JesusFreke/lalboard_stls/thumb_cluster_left_assembly.stl

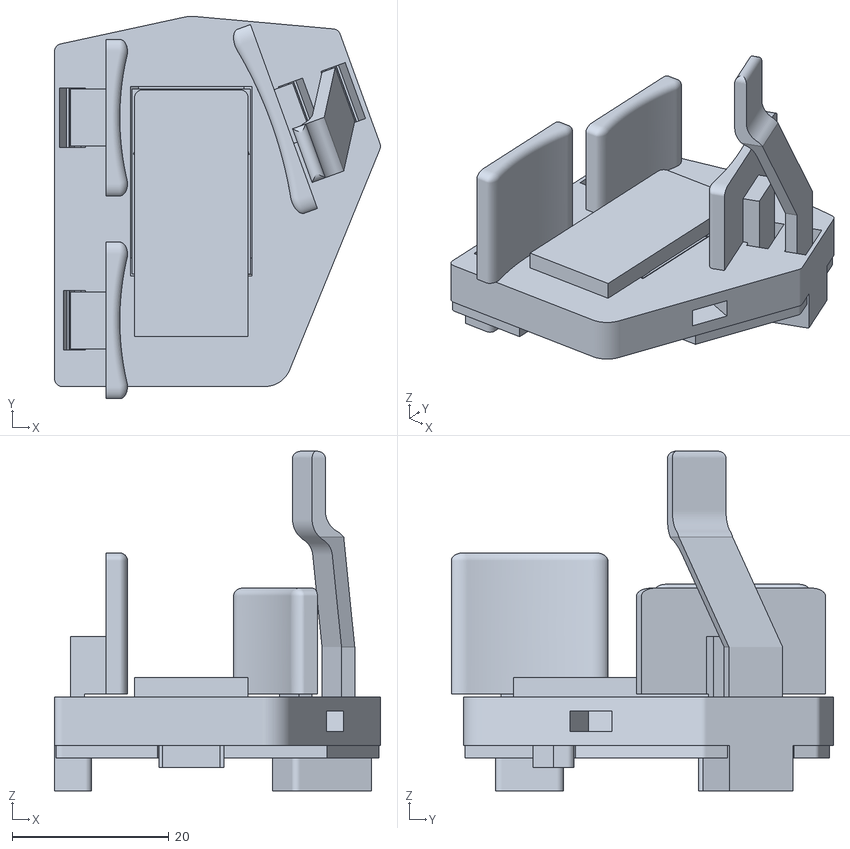
[picture p1: CAD file, 2021-03-22]
thumb_cluster_left_assembly.stl
41.6 x 48.8 x 43.4
