JesusFreke/lalboard_stls/central_pcb_spacer.3mf

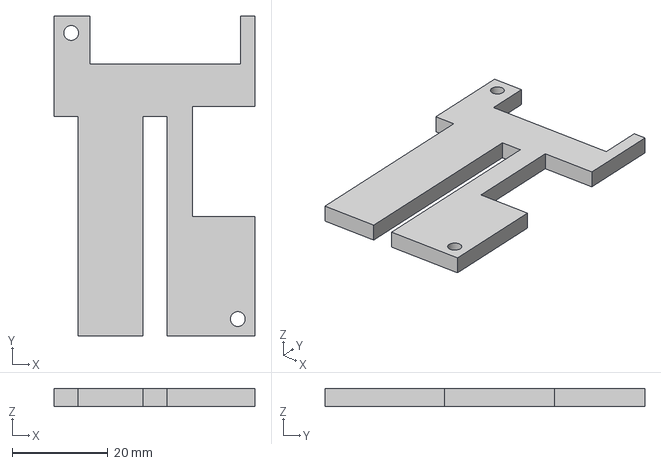
[picture p2: CAD file, 2024-06-17]
central_pcb_spacer.3mf
42.0 x 67.0 x 3.80 mm
