JesusFreke/lalboard_stls/cluster_pcb_sketch.dxf

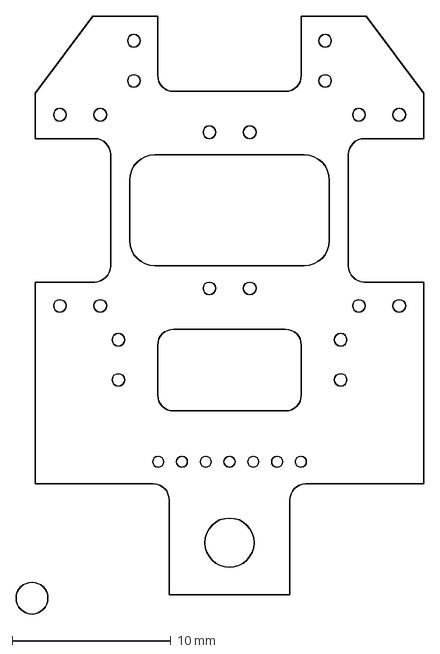
[picture p3: CAD file, 2023-11-19]
cluster_pcb_sketch.dxf
25.7 x 37.7 mm
