JesusFreke/lalboard_stls/thumb_cluster_insertion_tool.3mf

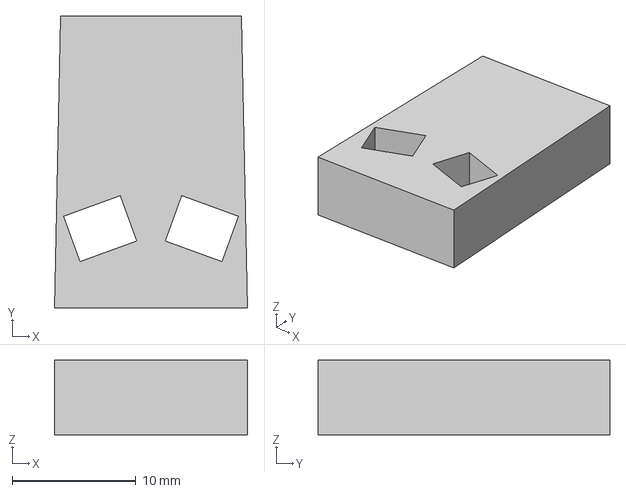
[picture p4: CAD file, 2023-11-09]
thumb_cluster_insertion_tool.3mf
15.6 x 23.6 x 6.04 mm
