JesusFreke/lalboard_stls/steel_base_lower_left.3mf

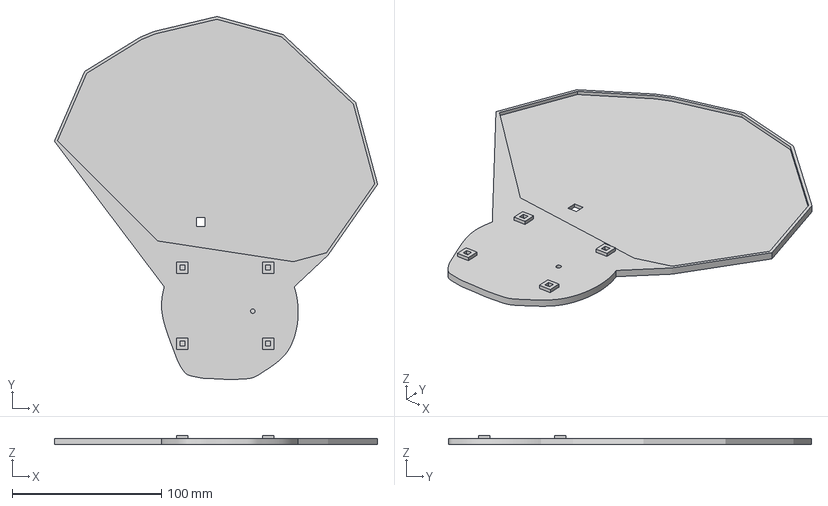
[picture p5: CAD file, 2023-11-09]
steel_base_lower_left.3mf
216.9 x 243.6 x 6.00 mm
