JesusFreke/lalboard_stls/cluster_front_mount_clip.3mf

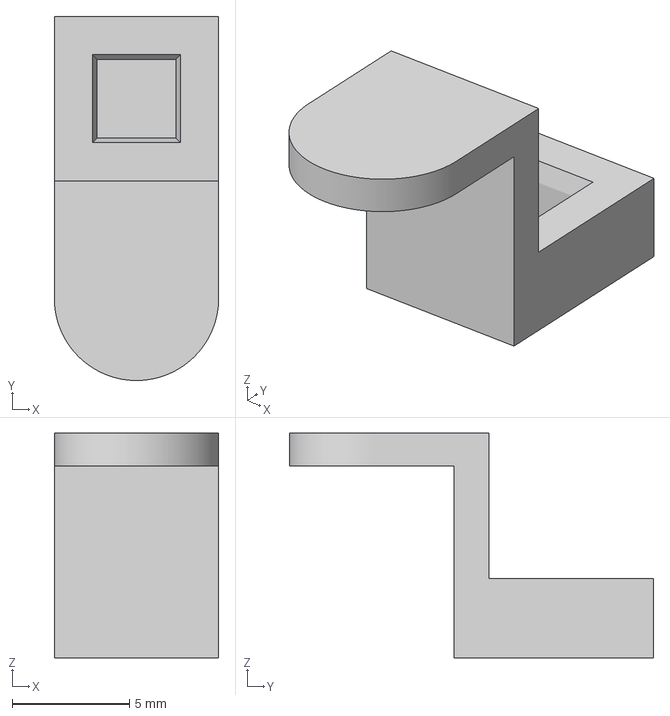
[picture p6: CAD file, 2023-11-09]
cluster_front_mount_clip.3mf
7.00 x 15.5 x 9.57 mm
