JesusFreke/lalboard_stls/steel_base_upper_left.3mf

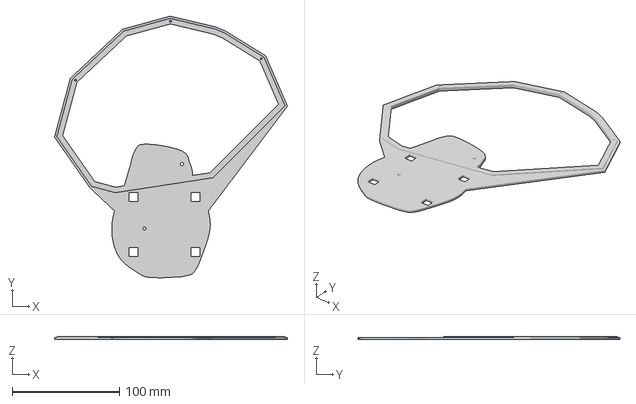
[picture p7: CAD file, 2023-11-09]
steel_base_upper_left.3mf
216.9 x 243.6 x 3.20 mm
