JesusFreke/lalboard_stls/cluster_front_mount_clip_tall.3mf

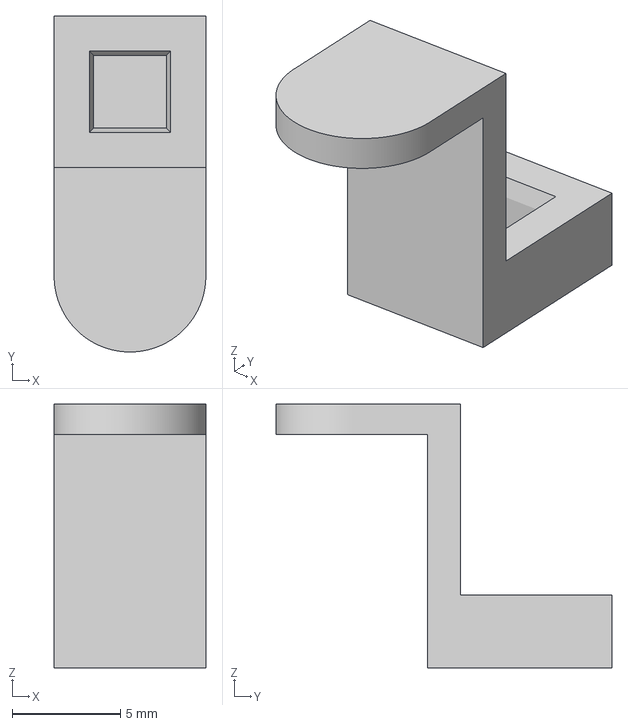
[picture p8: CAD file, 2023-11-09]
cluster_front_mount_clip_tall.3mf
7.00 x 15.5 x 12.2 mm
