JesusFreke/lalboard_stls/cluster_key_short.3mf

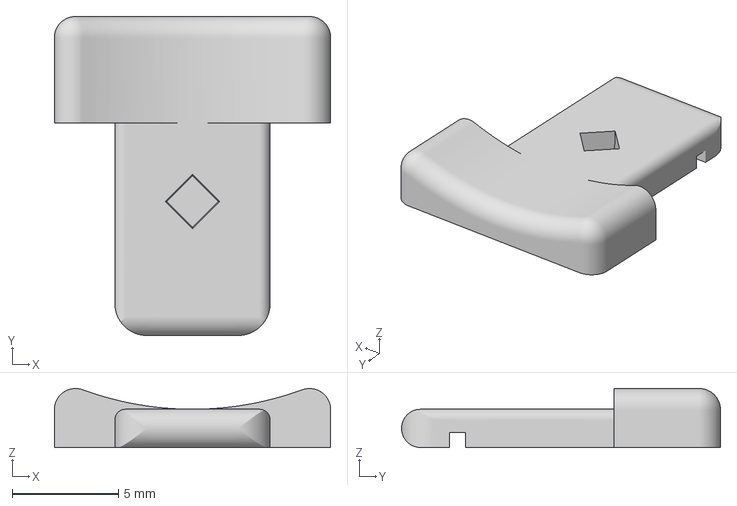
[picture p9: CAD file, 2023-11-09]
cluster_key_short.3mf
13.0 x 15.0 x 2.78 mm
