JesusFreke/lalboard_stls/thumb_cluster_right.3mf

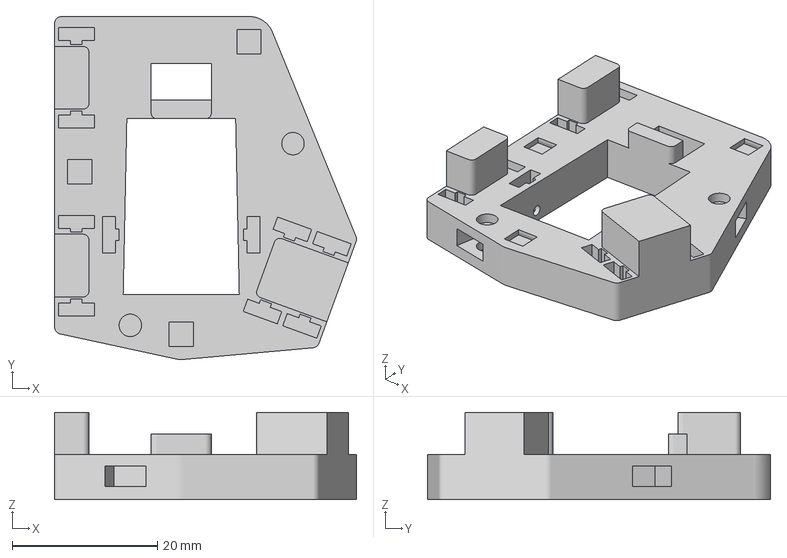
[picture p10: CAD file, 2023-11-09]
thumb_cluster_right.3mf
41.6 x 47.3 x 12.0 mm
