JesusFreke/lalboard_stls/thumb_pcb_left.3mf

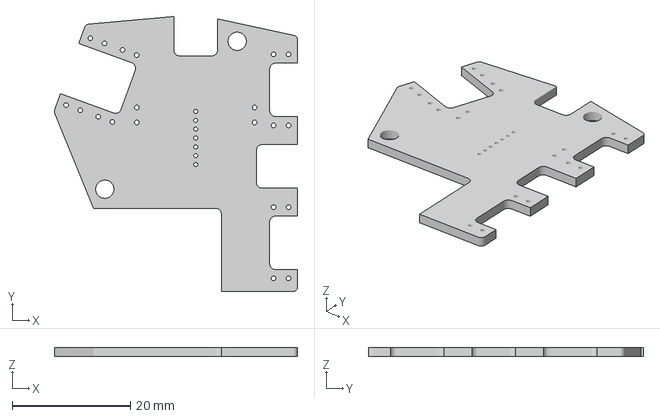
[picture p11: CAD file, 2023-11-09]
thumb_pcb_left.3mf
41.2 x 46.6 x 1.60 mm
