JesusFreke/lalboard_stls/thumb_key_down.3mf

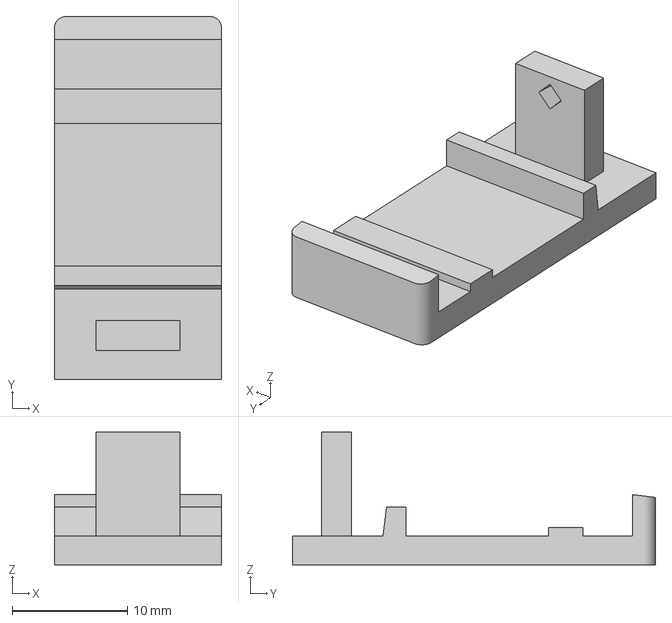
[picture p12: CAD file, 2023-11-09]
thumb_key_down.3mf
14.5 x 31.5 x 11.5 mm
