JesusFreke/lalboard_stls/support_base.3mf

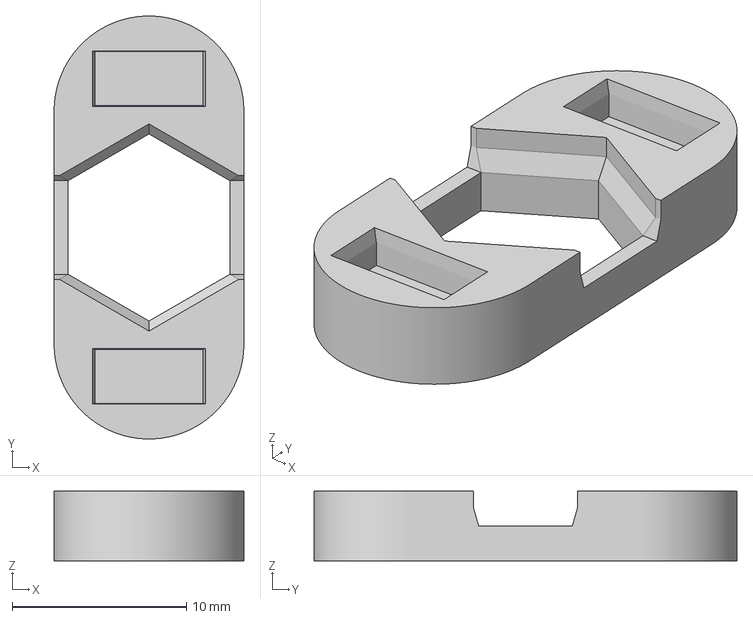
[picture p13: CAD file, 2023-11-09]
support_base.3mf
10.9 x 24.3 x 4.00 mm
