JesusFreke/lalboard_stls/cluster_key_tall.3mf

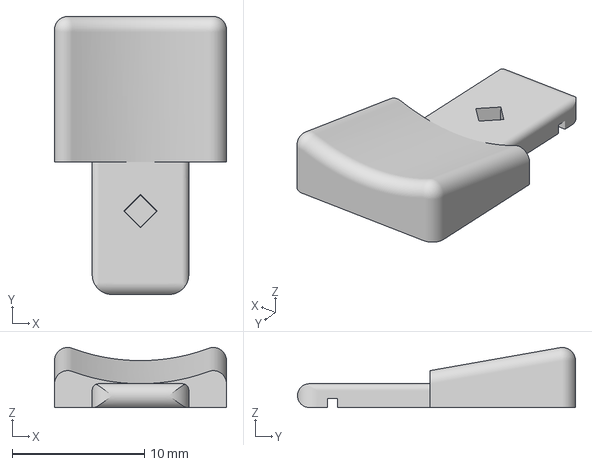
[picture p14: CAD file, 2023-11-09]
cluster_key_tall.3mf
13.0 x 21.0 x 4.54 mm
