JesusFreke/lalboard_stls/cluster.3mf

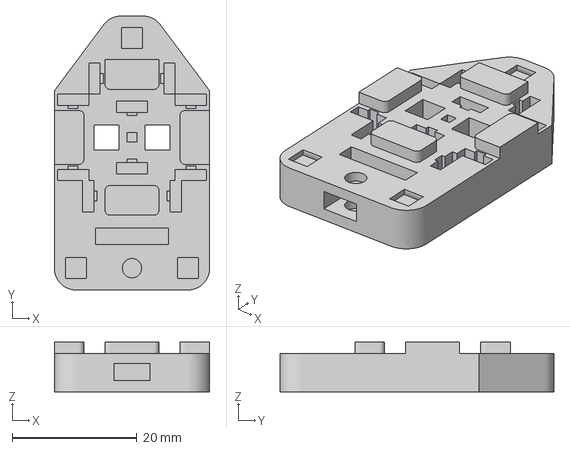
[picture p15: CAD file, 2023-11-09]
cluster.3mf
24.9 x 43.9 x 8.00 mm
