JesusFreke/lalboard_stls/thumb_key_mode_right.3mf

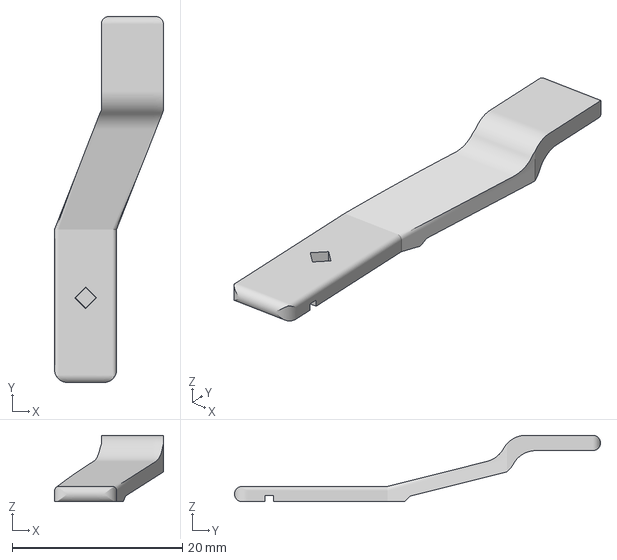
[picture p16: CAD file, 2023-11-09]
thumb_key_mode_right.3mf
12.8 x 43.0 x 7.80 mm
