JesusFreke/lalboard_stls/cluster_key_center.3mf

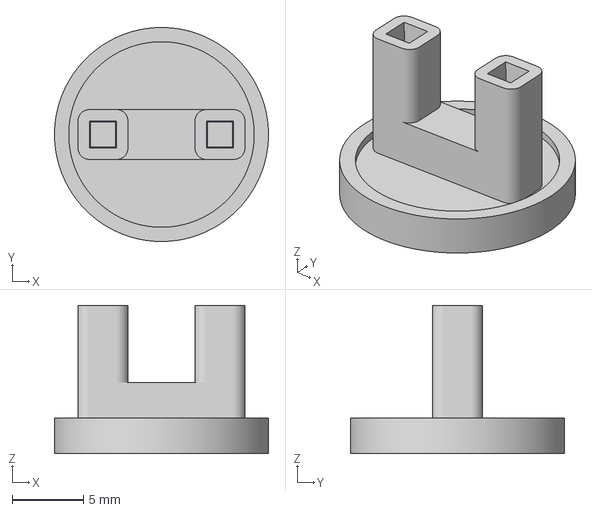
[picture p17: CAD file, 2023-11-09]
cluster_key_center.3mf
15.0 x 15.0 x 10.4 mm
