JesusFreke/lalboard_stls/thumb_key_inner.3mf

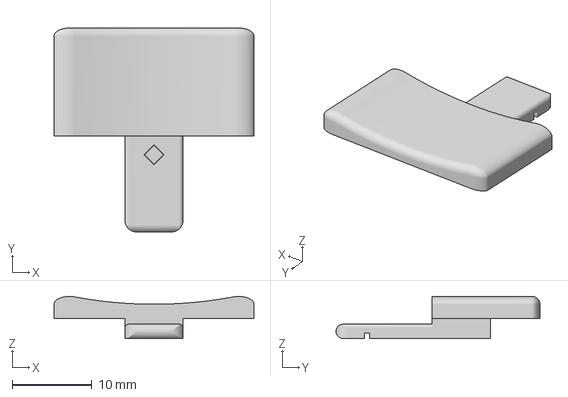
[picture p18: CAD file, 2023-11-09]
thumb_key_inner.3mf
25.0 x 25.5 x 5.27 mm
