JesusFreke/lalboard_stls/thumb_key_outer_lower.3mf

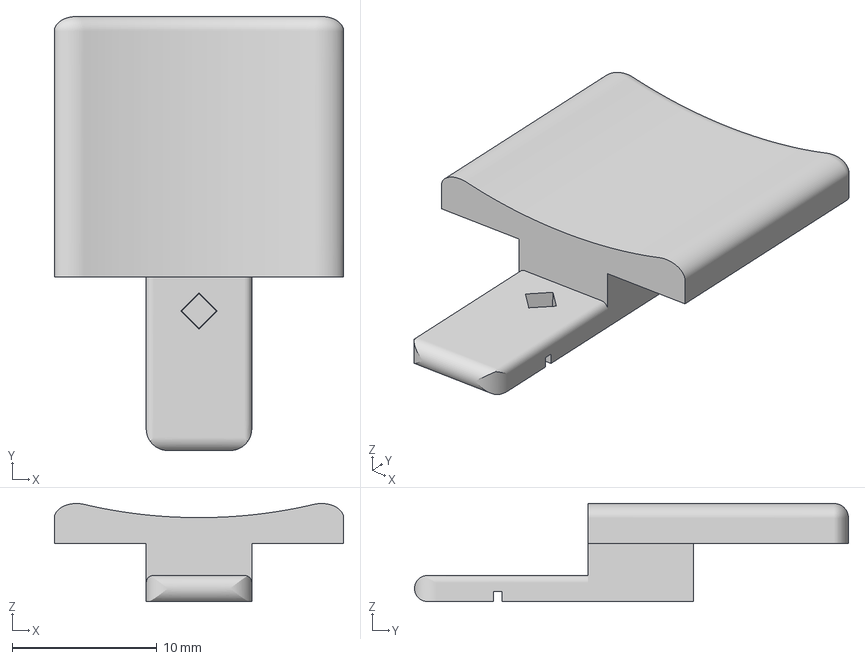
[picture p19: CAD file, 2023-11-09]
thumb_key_outer_lower.3mf
20.0 x 30.0 x 6.77 mm
