JesusFreke/lalboard_stls/thumb_key_outer_upper.3mf

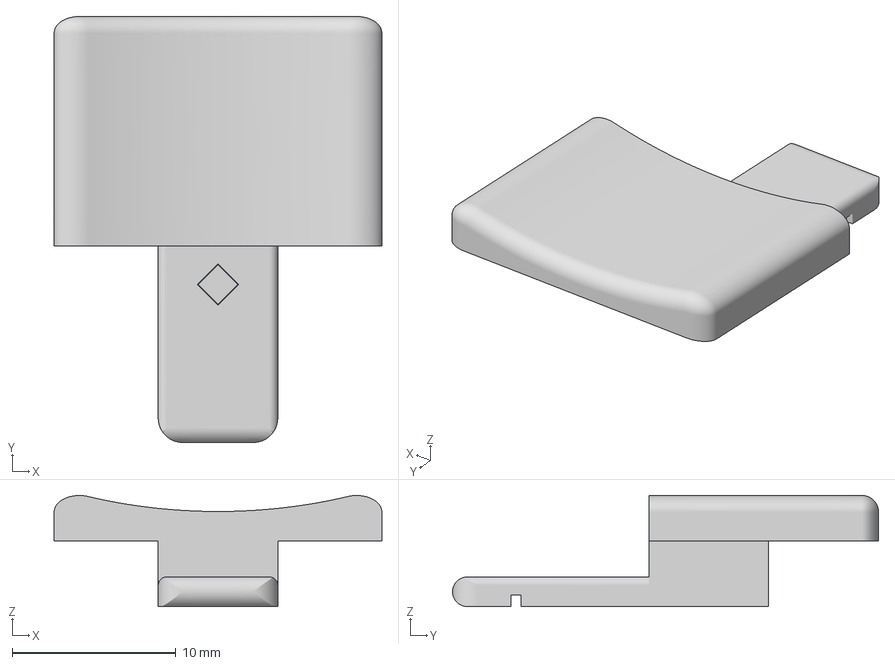
[picture p20: CAD file, 2023-11-09]
thumb_key_outer_upper.3mf
20.0 x 26.0 x 6.77 mm
