JesusFreke/lalboard_stls/handrest_right.3mf

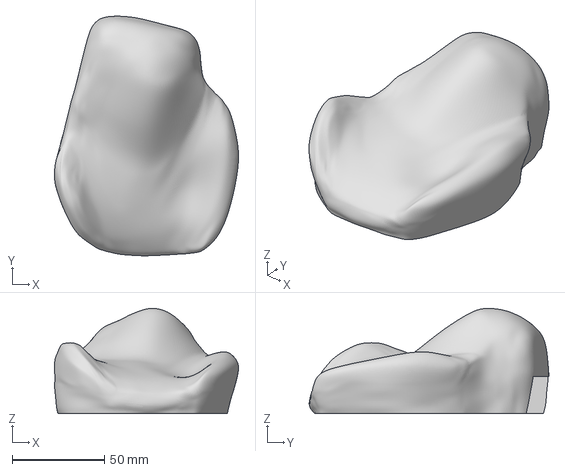
[picture p21: CAD file, 2023-11-09]
handrest_right.3mf
99.5 x 129.6 x 56.9 mm
