JesusFreke/lalboard_stls/steel_sheet_right_sketch.dxf

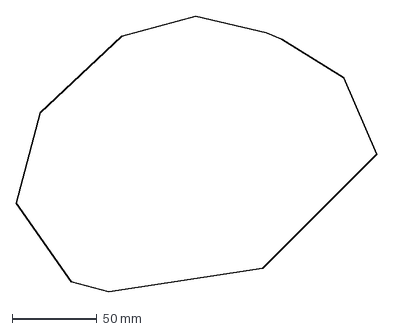
[picture p22: CAD file, 2021-05-22]
steel_sheet_right_sketch.dxf
212.4 x 162.2 mm
