JesusFreke/lalboard_stls/thumb_pcb_left_sketch.dxf

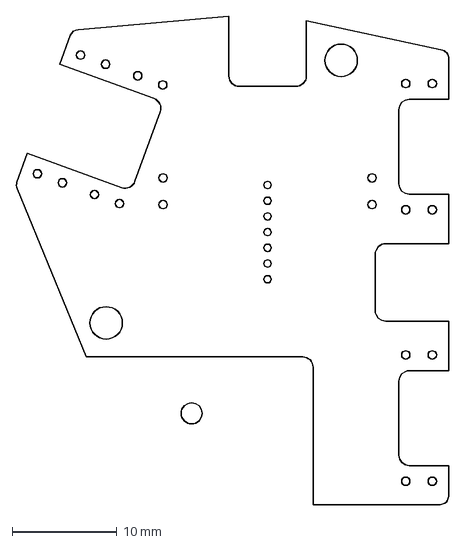
[picture p25: CAD file, 2021-05-02]
thumb_pcb_left_sketch.dxf
41.3 x 46.6 mm
