JesusFreke/lalboard_stls/central_pcb_sketch.dxf

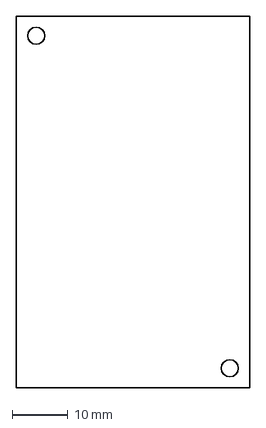
[picture p26: CAD file, 2021-04-28]
central_pcb_sketch.dxf
42.0 x 67.0 mm
