JesusFreke/lalboard_stls/(list of files, cad)

Other CAD files:
thumb_cluster_right_assembly.stl
thumb_pcb_right.3mf
steel_base_lower_right.3mf
steel_base_upper_right.3mf
thumb_key_mode_left.3mf
thumb_cluster_left.3mf
handrest_left.3mf
handrest_left.stl
handrest_right.stl
screw_11.3mf
screw_7.3mf
screw_base_14.3mf
screw_base_20.3mf
screw_base_20.stl
screw_base_4.3mf
screw_base_6.3mf
screw_base_8.3mf
screw_nut.3mf
static_base_left_full_assembly.f3d
static_base_right_full_assembly.f3d
