JesusFreke/lalboard_stls/(commit log)

2019-02-12 Add exported stls for all of the models
    [ballscrew_base_tiny.stl, ballscrew_cap.stl, ballscrew_tiny.stl, center_key.stl, central_pcb.stl, central_pcb_tray.stl, cluster.stl, cluster_pcb.stl]
2019-02-23 Make the center down key post a square
    The previous circular post with a flat face had a tendency to get wedged
    into the hole if the key was rotated while pressing it
    [center_key.stl, cluster.stl, cluster_pcb.stl]
2019-02-23 Rotate the magnets in the main key cluster 45 degrees
    This gets rid of the troublesome bridge over the top of the magnet hole.
    There always seemed to be drooping plastic there that would interfere with
    inserting the magnets, requiring excessive force to force the excess
    plastic out of the way
    [center_key.stl, cluster.stl, long_side_key.stl, short_side_key.stl]
2019-02-24 Increase the margin on the bottom of the clusters around the ball socket to .8mm
    The narrow .4mm line on the outside would sometimes not get good bed
    adhesion and pull up while printing
    [cluster.stl, cluster_pcb.stl, left_thumb_cluster.stl, left_thumb_cluster_pcb.stl, right_thumb_cluster.stl, right_thumb_cluster_pcb.stl]
2019-02-25 Increase the height of the light interruptor on the center down key
    It wasn't blocking enough light to trigger the key
    [center_key.stl]
2019-02-25 Make the middle of the center key post thinner
    There tends to be some layer irregularities on the post where the magnet
    hole ends. With a straight post, those irregularies have to be filed/cut
    down for a proper fit. This reduces the impact of the irregularities,
    so that only the front face of the post (with the magnet) should need to
    be cleaned up.
    [center_key.stl]
2019-02-26 Remove the fillet on the inner edge of the light interruptor on the center key
    This increases the amount of light blocked
    [center_key.stl]
2019-02-26 Extend the walls in front of the led/phototransistor for the center key
    This should reduce the amount of that light that leaks around the side
    of the light interruptor on the center key
    [cluster.stl]
2019-02-28 Change the rotation of the magnet pair for the central down key back to horizontal
    The rotated magnet doesn't feel quite as clicky
    [center_key.stl, cluster.stl]
2019-02-28 Reduce the offset of the side key magnet.
    After rotating the magnets, the key actuation force feels a bit too low
    [short_side_key.stl]
2019-02-28 Increase the size of the magnet hole in the side keys
    After rotating the magnet, the void was a bit too small
    [long_side_key.stl, short_side_key.stl]
2019-02-28 Move the center key magnet down a bit
    This places the magnet more centrally on the key post, which makes it
    easier to insert -- The light interruptor nubbin on the back doesn't
    interfere with plier placement on the back of the post.
    [center_key.stl, cluster.stl]
2019-03-01 Make the bottom horizontal for the magnet holes for the central key
    The sides should be sloped, but the bottom shouldn't
    [center_key.stl, cluster.stl]
2019-03-01 Get rid of the peaked magnet hole, and move the center magnets down a bit more
    The peaked magnet hole worked, but I didn't particularly like how it looked.
    This changes it back to the older squarish magnet hole.
    The nubbin on the center key was still interfering with the pliers a bit
    when inserting the magnet, so this also moves the magnets down a bit
    further.
    [center_key.stl, cluster.stl]
2019-03-01 Increase the y size of the central post by .1
    The central hole is square, and since there is no gap between the
    front face of the central post and the hole, the gap on the back side is
    twice as large as that on the 2 sides.
    This increases the size of the post so the gap between the post and hole
    on the back and sides is the same.
    [center_key.stl]
2019-03-14 Tweak the magnet height on the thumb side keys
    They had become slightly offset from the cluster magnet after the magnet
    rotation change
    [inner_thumb_key.stl, left_thumb_mode_key.stl, outer_lower_thumb_key.stl, outer_upper_thumb_key.stl, right_thumb_mode_key.stl]
2019-03-14 Rotate the magnets for the thumb down key
    [left_thumb_cluster.stl, right_thumb_cluster.stl, thumb_down_key.stl]
2019-03-14 Increase the width of the groove on the back of the thumb mode key
    Due to the way the mode key in particular tends to get torqued, there would
    be an annoying click as the groove just catches on the corresponding ridge,
    and then slips past it.
    [left_thumb_mode_key.stl, right_thumb_mode_key.stl]
2019-07-31 Add hand rest components
    [board shield 7.STL, board shield 8.STL, rest bottom 6.STL, rest top 6.STL]
2019-08-01 Increase vertical space below board frame to account for longer Teensy pins
    [rest bottom 6.STL]
2020-06-29 Switch to a 1x1x1mm magnet for the center down keys
    The previous 1/16" cube magnets needed to be partially demagnetized, in
    order to get a low enough key force. But I was able to find some N50
    1x1x1mm magnets that work perfectly as-is, without the need to partially
    demagnetize them.
    [center_key.stl]
2020-06-29 Add a small cutout to help with inserting the "lower outer" magnet on the thumb
    [left_thumb_cluster.stl, right_thumb_cluster.stl]
2020-08-14 Fix the right handrest
    It was previously the same as the left hand side.
    [right_handrest.stl]
2021-03-12 Add a new "export_parts.py" script, and regenerate all the .stls
    [ballscrew_base_tiny.stl, ballscrew_cap.stl, ballscrew_tiny.stl, board shield 7.STL, board shield 8.STL, center_key.stl, central_pcb.stl, central_pcb_tray.stl]
2021-03-15 Add the ability to export sketches as .dxf to export_parts.py
    This also updates all the exported parts files.
    [cluster.stl, cluster_front_mount_clip.stl, cluster_front_mount_clip_tall.stl, cluster_pcb.stl, cluster_pcb_sketch.dxf, screw_base_16.stl, screw_base_20.stl, screw_base_4.stl]
2021-03-15 Remove the front nubbins of the cluster pcb
    They were originally intended to be held down by a clip in the front, but
    that's not really needed now, with the screw holding the pcb down.
    [cluster_pcb_sketch.dxf]
2021-03-17 Rename cluster_key_long to cluster_key_tall
    "tall" is the more appropriate opposite of "short" in this context.
    [cluster_key_tall.stl]
2021-03-18 Add support for generating various exports for assemblies in export_parts.py
    This will export an assembly as an stl, an f3d, and to a specific
    fusion 360 cloud instance (which can then be shared via link, for viewing
    on the web by anyone)
    [cluster.stl, cluster_assembly.f3d, cluster_body_assembly.f3d, cluster_body_assembly.stl, cluster_key_center.stl, cluster_key_short.stl, cluster_key_tall.stl, cluster_pcb.stl]
2021-03-19 Add a virtual "locating pin" to the cluster pcb sketch
    This gives a reference point for the origin of the sketch, so the import
    location can be set correctly when importing the outline into kicad.
    Basically, you set the grid origin in kicad to the center of the circle
    (assuming the locating pin is already in kicad) and then make a note of
    the coordinates of that point. And then, when importing the outline, you
    can specify those coordinates as the location, to ensure the origin of the
    imported outline matches that of the existing/previous outline.
    [cluster_pcb_sketch.dxf]
2021-03-19 Add _sketch parts for the thumb pcbs, to generate the outline .dxf files.
    [cluster_assembly.f3d, cluster_body_assembly.f3d, cluster_body_assembly.stl, cluster_pcb.stl, cluster_pcb_sketch.dxf, screw_support_assembly.f3d, thumb_cluster_insertion_tool.stl, thumb_cluster_left.stl]
2021-03-20 Fillet the remaining sharp corners on the thumb cluster
    It seems silly to have 2 sharp corners, with the rest being filleted
    [thumb_cluster_insertion_tool.stl, thumb_cluster_left.stl, thumb_cluster_left_assembly.f3d, thumb_cluster_left_assembly.stl, thumb_cluster_right.stl, thumb_cluster_right_assembly.f3d, thumb_cluster_right_assembly.stl, thumb_pcb_left.stl]
2021-03-20 Add a fillet to the cutout in the thumb pcb for the down key
    This also fillets the sticky-down part of the keywell for the down-key,
    to match the fillet in the pcb.
    [cluster.stl, cluster_assembly.f3d, cluster_body_assembly.f3d, cluster_body_assembly.stl, cluster_pcb.stl, cluster_pcb_sketch.dxf, screw_support_assembly.f3d, thumb_cluster_left.stl]
2021-03-22 Tweak the screw positions for the thumb cluster
    Minor tweaks to improve the pcb placement of the screw holes
    [thumb_pcb_left_sketch.dxf]
2021-03-22 Fix thumb_pcb_right_sketch.py
    It was mirrored, like the left clustered.
    [thumb_pcb_right_sketch.dxf]
2021-03-22 Update all the exported stls, etc.
    [cluster_assembly.f3d, cluster_body_assembly.f3d, cluster_body_assembly.stl, cluster_pcb.stl, cluster_pcb_sketch.dxf, thumb_cluster_left.stl, thumb_cluster_left_assembly.f3d, thumb_cluster_left_assembly.stl]
2021-03-22 Update the exported thumb parts
    [thumb_cluster_left.stl, thumb_cluster_left_assembly.f3d, thumb_cluster_right.stl, thumb_cluster_right_assembly.f3d, thumb_pcb_left.stl, thumb_pcb_left_sketch.dxf, thumb_pcb_right.stl, thumb_pcb_right_sketch.dxf]
2021-04-17 Update the stls
    [central_pcb.stl, central_pcb_sketch.dxf, central_pcb_tray.stl, cluster.stl, cluster_assembly.f3d, cluster_body_assembly.f3d, cluster_body_assembly.stl, cluster_front_mount_clip.stl]
2021-04-24 update stls
    [central_pcb.stl, central_pcb_sketch.dxf, cluster_assembly.f3d, cluster_body_assembly.f3d, cluster_body_assembly.stl, cluster_pcb.stl, cluster_pcb_sketch.dxf, screw_support_assembly.f3d]
2021-04-28 Remove some of the extraneous exported files
    This removes the exported assembly files and the stls for the pcb objects.
    These aren't really needed, and take up quite a bit of space.
    The assembly files in particular are the largest in the repository, and
    the f3ds were being needlessly updated after every export.
    The assemblies are still being exported to the fusion cloud though, for
    convenient viewing on the web.
    [central_pcb.stl, central_pcb_sketch.dxf, central_pcb_tray.stl, cluster_assembly.f3d, cluster_body_assembly.f3d, cluster_body_assembly.stl, cluster_pcb.stl, cluster_pcb_sketch.dxf]
2021-05-09 Change screw_base_16 to screw_base_14
    A length of 14 provides more useful coverage of the possible total lengths
    [screw_base_14.stl, screw_base_16.stl]
2021-05-09 Switch out screw_13 for screw_11
    The screw with 13mm threaded length was a bit too long to fully
    cover the possible lengths between the crossover from the short
    screw. 11mm is still plenty long, and ensures full coverage of
    the possible screw+base lengths.
    [screw_11.stl, screw_13.stl]
2021-05-22 Add sketches for the steel sheets
    [steel_sheet_left_sketch.dxf, steel_sheet_right_sketch.dxf]
2021-05-22 Add stls for the new steel-sheet base
    This also gets rid of the now-defunct central_pcb_tray
    [central_pcb_spacer.stl, central_pcb_tray.stl, steel_base_lower_left.stl, steel_base_lower_right.stl, steel_base_upper_left.stl, steel_base_upper_right.stl, steel_sheet_right_sketch.dxf]
2021-06-05 Remove the old "thumb clip" part
    [thumb_clip_left.stl, thumb_clip_right.stl]
2023-10-07 stls for new center key mechanism
    [cluster.stl, cluster_key_center.stl, cluster_pcb_sketch.dxf]
2023-10-10 Add magnet to front of cluster
    [cluster.stl, cluster_front_mount_clip.stl, cluster_front_mount_clip_tall.stl]
2023-10-11 Square center holes
    [cluster.stl, cluster_pcb_sketch.dxf]
2023-10-12 Square-ish posts for center key
    [cluster_key_center.stl]
2023-11-09 Deeper magnets in handrests
    [handrest_left.3mf, handrest_right.3mf]
2023-11-09 replace stls with 3mfs
    [central_pcb_spacer.3mf, central_pcb_spacer.stl, cluster.3mf, cluster.stl, cluster_front_mount_clip.3mf, cluster_front_mount_clip.stl, cluster_front_mount_clip_tall.3mf, cluster_front_mount_clip_tall.stl]
2023-11-19 Widen the slot for the center key in the cluster pcb
    [cluster_pcb_sketch.dxf]
2023-11-19 Update central pcb spacer
    Add slots in the spacer for the header pins
    [central_pcb_spacer.3mf]
2024-06-17 Thicker pcb spacer
    [central_pcb_spacer.3mf]
2025-02-24 Add the assembly .f3d files
    [static_base_left_full_assembly.f3d, static_base_right_full_assembly.f3d]
